ORelio/DCF77-Transmitter/dcf77-transmitter.ino

/* (c) 2018-2020 Luigi Calligaris. GPL v2+ */
/* (c) 2023-2024 ORelio - bug fixes and improvements */

#include <ESP8266WiFi.h>
#include "time.h"
#include "dcf77protocol.h"
// #include "dcf77protocol.c" // Uncomment in case compiler does not include it automatically

/* ==============
 *  BEGIN CONFIG
 * ============== */

// This program allows syncing clocks using the DCF77 protocol in places where DCF77 is not available
// DCF77 is a German longwave time signal and standard-frequency radio station running in Europe at 77.5 kHz
// https://en.wikipedia.org/wiki/DCF77

// In order to use this program, you need an ESP8266-based microcontroller such as D1 Mini, some wire and a 330 Ohm resistor (recommended range: 330-500 Ohm).
// [Your Wi-Fi router] <-- (retrieves time: NTP protocol over Wi-Fi) <-- [ESP8266] --> (transmits time: DCF77 signal at 77.5 kHz) --> [clock]
// Wiring of the ESP8266 is as follows: GPIO PIN --- [330 Ohm] --- [COIL] --- GND PIN
// Make a coil with some wire. Start with a coil of ~10cm diameter with ~10 loops to generate a short-distance magnetic field (~10cm), then adjust to your needs.
// DISCLAIMER: Sending a stronger signal to cover a larger area is likely forbidden by your local laws. Do not use an actual antenna or send amplified signal without knowing what you are doing.
// NOTE: DCF77 signaling is slow. Each time code takes a whole minute to transmit. Devices should need at least 1-3 minutes to properly synchronize to the signal.

// Wi-Fi configuration
//const char* wifi_ssid   = "MyWiFiNetwork";
//const char* wifi_pass   = "S3cr3tWiFiP4ssw0rd";

// NTP configuration
const char* ntp_server = "pool.ntp.org"; // https://www.ntppool.org/use.html - https://www.ntppool.org/tos.html
const char* time_zone = "CET-1CEST-2,M3.5.0/02:00:00,M10.5.0/03:00:00"; // Pick a time zone from https://remotemonitoringsystems.ca/time-zone-abbreviations.php
const int ntp_sync_interval_hours = 3; // How many hours between NTP syncs over Wi-Fi. Transmitter temporarily stops when syncing over Wi-Fi. ESP's internal clock is imprecise, keep the value low.

// GPIO Pin configuration
const unsigned pwm_pin = 5;           // Antenna pin GPIO# - See https://randomnerdtutorials.com/esp8266-pinout-reference-gpios/
const unsigned led_pin = LED_BUILTIN; // LED pin GPIO# or use LED_BUILTIN - See https://randomnerdtutorials.com/esp8266-pinout-reference-gpios/
const bool led_enabled = true;        // Enable or disable built-in led. If enabled, the LED flashes in transmitting mode, and stays on when syncing with NTP over Wi-Fi.

// Intermittent mode - Optional, for advanced users
// ================================================
// Power saving mode for running on battery - Only transmit signal a few minutes per hour during the time span where the clock actually tries to synchronize with the time signal.
// Most clocks will try to synchronize every hour or every few hours a few minutes before o'clock. Adjust the values below to your needs.
// This mode uses ESP's deep sleep mode. Need to wire GPIO16 (D0) to RST for waking up from deep sleep, preferably using a resistor between 470-1K Ohm to avoid issues flashing the ESP.
// * Default implementation: Continuously transmit time, resync with NTP every few hours according to ntp_sync_interval_hours defined above. Compliant with Ntppool.org ToS.
// * Intermittent implementation: Only transmit time for a few minutes per hour, put ESP to deep sleep for the rest of the hour, then resync with NTP server and resume transmitting.
// Important note about time keeping during deep sleep - Clock drift
//  Putting the ESP into deep sleep mode will induce drift in its internal clock, so in this mode NTP sync happens *every hour* (on wakeup), regardless of sync interval set above.
//  The ESP *will* wake a few minutes too soon or too late due to clock drift, so adjust sleep_clock_correction to compensate, and define a transmission time span slightly larger than needed.
//  You should switch to a NTP service that allows syncing every hour at the same time (Ntppool.org does not allow this), or set up your own server - easy if you have a Linux system on your LAN.
//  Installing NTP server on raspbian (raspberry pi): "apt install ntp", then remove "limited" keyword in "restrict" directive in "/etc/ntp.conf", then "service ntp restart". Done.
// Relevant documentation:
//  https://nodemcu.readthedocs.io/en/dev/modules/rtctime/
//  https://www.ntppool.org/tos.html
//  https://vitux.com/how-to-setup-ntp-server-and-client-on-debian-11/
//  https://www.letscontrolit.com/wiki/index.php?title=Tutorial_Battery_Powered_Devices
//  https://www.esp8266.com/viewtopic.php?t=13101 // Problem flashing after RST and GPIO16 connected

// Intermittent mode configuration
const bool intermittent_mode = false;       // Set this to true to enable intermittent mode instead of continuous mode. Make sure to read caveats above.
const int tx_minute_start = 55;             // Start transmission on the specified minute. ESP *will* wake up too soon or too late, so adjust drift correction until getting satisfying results.
const int tx_duration_minutes = 10;         // Duration of transmission in minutes. After that, ESP will go to deep sleep to save power until next transmission.
const float sleep_clock_correction = 0.00f; // Set to 0.00f, run for a few hours. Note average sleep/wakeup time. correction = (desired_wakeup_time - actual_wakeup_time) / (actual_wakeup_time - sleep_start_time).
                                            // Example: Sleeping at 12:05:00, trying to wake up at 12:54:30 but waking up at ~12:48:45 -> correction = (54.5 - 48.75) / (48.75 - 5.00) -> correction = 0.17f

/* ============
 *  END CONFIG
 * ============ */

// Constants for generating DCF77 sin wave base signal (77.5 kHz). Users of this sketch should not need to edit this.
const unsigned pwm_freq       = 25833; // ESP8266 cannot directly generate 77500 Hz frequency. We use the 3rd harmonic of 25833 Hz to obtain 77.5 kHz
const unsigned pwm_resolution = 3;     // Analog wave resolution (in bits)
const unsigned pwm_duty_off   = 0;     // Analog wave amplitude in OFF state. Signal should be an attenuated in this state per specs, but OFF works just fine.
const unsigned pwm_duty_on    = 3;     // Analog wave amplitude in ON state

// Global variables initialized during setup()
static uint8_t dcf77_data[DCF77_DATALEN];
static int ntp_sync_hour = 0;
static int ntp_sync_minute = 0;
static int ntp_sync_second = 0;
static int tx_minutes_remaining = 0;

void PrintLocalTime()
{
	time_t rawtime;
	time(&rawtime);
	Serial.print(ctime(&rawtime));
	Serial.print("\r");
}

void SwitchLed(bool on)
{
	if (on && led_enabled)
	{
		digitalWrite(led_pin, LOW);
	}
	else digitalWrite(led_pin, HIGH);
}

void DeepSleepCorrected(uint64_t delay_microseconds, float correction_factor)
{
	// Adjust deep sleep delay using expected internal clock drift factor. See formula in config.
	uint64_t delay_corrected = delay_microseconds + delay_microseconds * sleep_clock_correction;
	int sleep_minutes = delay_microseconds / 60000000;
	int sleep_seconds = (delay_microseconds % 60000000) / 1000000;
	Serial.printf("Sleeping for %d:%d minutes. Correction factor: %02.2f. Sleep delay: %lu µs", sleep_minutes, sleep_seconds, correction_factor, (long unsigned)delay_corrected);
	Serial.println();
	ESP.deepSleep(delay_corrected); // ESP.deepSleep() never returns, need to wire D0 to RST so that ESP resets itself after specified delay.
}

struct tm *NtpSync()
{
	time_t rawtime;
	struct tm * timeinfo;
	int delay_retries;

	Serial.println("Starting NTP Sync over Wi-Fi");
	SwitchLed(1);

	Serial.print("Connecting to ");
	Serial.print(wifi_ssid);
	WiFi.setHostname("DCF77GW");
	WiFi.begin(wifi_ssid, wifi_pass);
	delay_retries = 0;
	while (WiFi.status() != WL_CONNECTED) {
		delay(1000);
		Serial.print(".");
		if (++delay_retries == 30) {
			Serial.println(" Timeout");
			if (intermittent_mode)
			{
				// Give up for this hour to save power, adjusting sleep delay by deducting time since boot.
				Serial.println("Failed to connect to Wi-Fi access point, retrying next hour.");
				DeepSleepCorrected((uint64_t)3600000000 - system_get_time(), sleep_clock_correction);
			}
			else
			{
				Serial.println("Failed to connect to Wi-Fi access point, reseting.");
				ESP.reset(); // Give up after 30 seconds and hard reset the ESP to make sure the Wi-Fi chip will reboot as well
			}
		}
	}
	Serial.println(" Connected");

	Serial.print("Syncing with ");
	Serial.println(ntp_server);
	delay_retries = 0;
	configTime(time_zone, ntp_server); // https://github.com/esp8266/Arduino/blob/master/cores/esp8266/time.cpp
	while (timeinfo->tm_year == 70 && timeinfo->tm_yday == 0); // january 1st 1970 means not synced yet
	{
		delay(1000);
		time(&rawtime);
		timeinfo = localtime(&rawtime);
		PrintLocalTime();
		if (++delay_retries == 30) {
			Serial.println("Timeout");
			if (intermittent_mode)
			{
				// Give up for this hour to save power, adjusting sleep delay by deducting time since boot.
				Serial.println("Failed to sync with NTP server, retrying next hour.");
				DeepSleepCorrected((uint64_t)3600000000 - system_get_time(), sleep_clock_correction);
			}
			else
			{
				Serial.println("Failed to sync with NTP server, restarting.");
				ESP.restart(); // Give up after 30 seconds and restart program (clean reboot)
			}
		}
	}

	Serial.print("Disconnecting from ");
	Serial.println(wifi_ssid);
	WiFi.disconnect(true);
	WiFi.mode(WIFI_OFF);

	SwitchLed(0);
	Serial.println("NTP Sync done");
	return timeinfo;
}

void setup()
{
	Serial.begin(115200);
	Serial.println("Initializing NTP to DCF77 gateway");
	analogWriteFreq(pwm_freq);
	analogWriteRange(pwm_resolution);
	pinMode(led_pin, OUTPUT);

	struct tm *timeinfo = NtpSync();

	if (intermittent_mode)
	{
		tx_minutes_remaining = tx_duration_minutes;
		Serial.printf("Intermittent mode: Transmitting for %d minutes, then every hour around :%02d for %d minutes.", tx_duration_minutes, tx_minute_start, tx_duration_minutes);
		Serial.println();
	}
	else
	{
		Serial.println("Continuous mode: Transmitting all time long, except when syncing with NTP server.");
		ntp_sync_hour = (timeinfo->tm_hour + ntp_sync_interval_hours) % 24;
		ntp_sync_minute = timeinfo->tm_min % 40 + 10; // Always sync somewhere between 10 and 50, transmission must be stable around o'clock
		ntp_sync_second = timeinfo->tm_sec;
		Serial.printf("NTP will resync at %02d:%02d:%02d", ntp_sync_hour, ntp_sync_minute, ntp_sync_second);
		Serial.println();
	}

	Serial.print("Calculating current DCF time code: ");
	Serial.println(dcf77_encode_data(timeinfo, dcf77_data));
}

void loop()
{
	time_t rawtime;
	struct tm *timeinfo;
	struct timeval tv;
	time(&rawtime);
	timeinfo = localtime(&rawtime);

	// DCF77 radio is ON by default (signal transmitted at 100% strength)
	// It transmits one bit per second by attenuating transmission (from 100% to 15%) for 100ms (bit 0) or 200ms (bit 1).
	// See https://en.wikipedia.org/wiki/DCF77#Amplitude_modulation
	// Bits are sent in sync with each second so the receiver can synchronize its clock with transmitter.
	if (timeinfo->tm_sec < DCF77_DATALEN)
	{
		// Transmit bit (0 or 1)
		SwitchLed(1);
		analogWrite(pwm_pin, pwm_duty_off); // Instead of attenuating signal we completely stop it. Seems to work fine.
		delayMicroseconds(dcf77_data[timeinfo->tm_sec] == 0 ? 100000 : 200000); //100 ms = 0, 200 ms = 1
		SwitchLed(0);
		analogWrite(pwm_pin, pwm_duty_on);
	}
	else
	{
		// Last bit (59th bit) is not transmitted at all -not 0 nor 1- so the signal stays ON
		analogWrite(pwm_pin, pwm_duty_on);
	}

	// Status info over serial
	Serial.print("Transmitted bit ");
	if (timeinfo->tm_sec >= DCF77_DATALEN)
		Serial.print("-");
	else
		Serial.printf("%d", dcf77_data[timeinfo->tm_sec]);
	Serial.print(" @ ");
	PrintLocalTime();

	// Refresh data array every minute
	if (timeinfo->tm_sec == 0)
	{
		// At this point, we just retransmitted bit 0 (start of transmission) from previous payload. This bit is always 0.
		// We are now at second 0, dcf77_encode_data() can correctly compute next minute (payload time is one minute ahead).
		Serial.print("Calculating next DCF time code: ");
		Serial.println(dcf77_encode_data(timeinfo, dcf77_data));
	}

	// Continuous mode (default): Resync with NTP server when reaching next resync time. Resync time is calculated at startup.
	if (!intermittent_mode && timeinfo->tm_hour == ntp_sync_hour && timeinfo->tm_min == ntp_sync_minute && timeinfo->tm_sec == ntp_sync_second)
	{
		// Hard-Reset ESP to relaunch sync.
		// Just calling NtpSync() again could cause weird bugs such as issues with Wi-Fi or internal clock
		ESP.reset();
	}

	// Intermittent mode: Put ESP to deep sleep at end of transmission, then wake up every hour at the same minute for transmitting again.
	if (intermittent_mode && timeinfo->tm_sec == 0 && --tx_minutes_remaining == 0)
	{
		int sleep_minutes = tx_minute_start - timeinfo->tm_min;
		int wakeup_hour = timeinfo->tm_hour;
		if (sleep_minutes < 0) {
			// Fix values when tx start and tx end happen the same hour instead of overlapping around o'clock
			sleep_minutes += 60;
			wakeup_hour = (wakeup_hour + 1) % 24;
		}
		uint64_t delay_microseconds = (uint64_t)sleep_minutes * 60000000 - 30000000; // 30 seconds before tx_minute_start (need to initialize Wi-Fi and sync with NTP server)
		Serial.printf("Sleeping until %02d:%02d:30 +/- clock drift.", wakeup_hour, tx_minute_start);
		Serial.println();
		DeepSleepCorrected(delay_microseconds, sleep_clock_correction);
	}

	// Wait for next second before looping and transmitting next bit
	gettimeofday(&tv, NULL);
	delayMicroseconds(1000000-tv.tv_usec);
}
