ORelio/DCF77-Transmitter/(commit log)

2023-11-08 Fix time zone reverting to GMT
    Time zone was reverting to GMT on subsequent NTP syncs
    Also add debug output for values encoded in DCF time data
    [dcf77-transmitter.ino, dcf77protocol.c, dcf77protocol.h]
2023-11-30 Bug fixes
    Fix NtpSync() hanging on wi-fi reconnect by rebooting instead
    Fix incorrect NTP sync time calculation
    Revert default LED config to Enabled
    [dcf77-transmitter.ino]
2023-12-01 Improve DCF protocol implementation
    * Fix one second delay (each bit was transmitted one second late)
    * Properly recalculate next minute to handle dow/month/year/dst/etc
    * Implement summer time announcement (for one hour before change)
    [dcf77-transmitter.ino, dcf77protocol.c]
2023-12-03 Implement optional intermittent mode
    Allows transmitting time only a few minutes per hour
    Switch to deep sleep when inactive to save power
2023-12-05 NTP sync improvements
    * Fix NTP spam on slow sync
    * Sync on second derived from boot instead of second 00
    * Change default pool hostname and sync interval
    * Document deep sleep and firmware flash issue
    [dcf77-transmitter.ino]
